txyon/MoNE_Portfolio/ImagePlots/lenscals.jpg

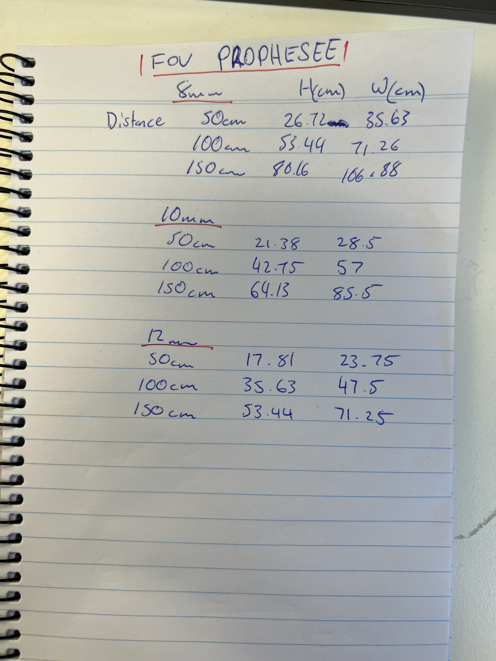
ImagePlots/lenscals.jpg
