txyon/MoNE_Portfolio/(commit log)

2024-01-13 Time filter for CSV files
2024-01-15 Original prototype code
    Built on psee413 by Alex. As seen in code added additional threads for bias controls to see if any constraints during manual testing.
2024-01-15 Hot Pixel Detection and Filtering
2024-01-15 Hot pixel detection and filter
