txyon/MoNE_Portfolio/ImagePlots/lux.jpg

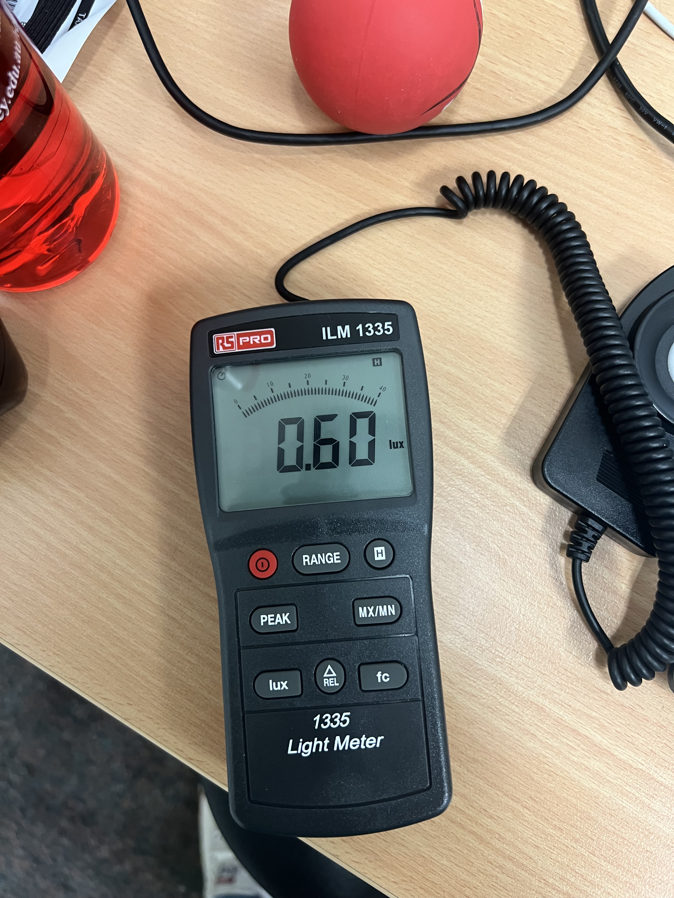
ImagePlots/lux.jpg
