txyon/MoNE_Portfolio/ExperimentSetup.jpg

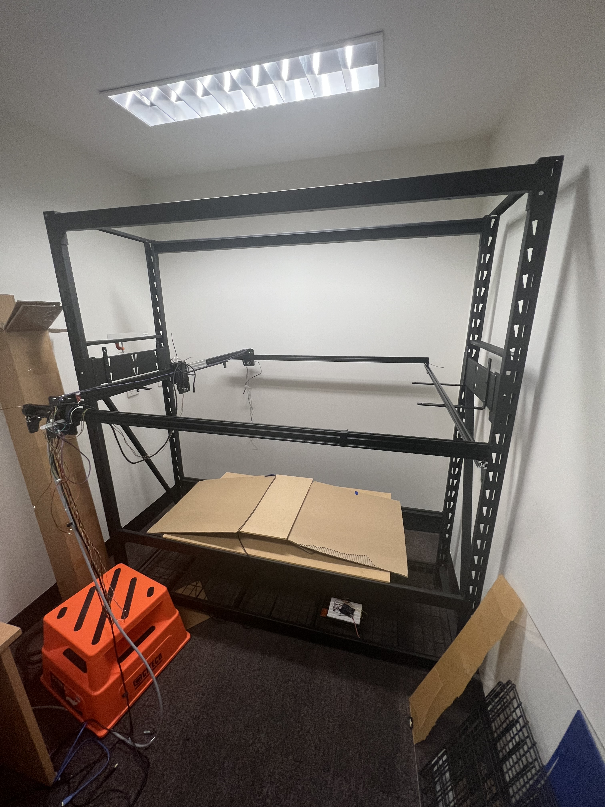
[picture p3: ImagePlots/ExperimentSetup.jpg]
ExperimentSetup.jpg
