txyon/MoNE_Portfolio/ImagePlots/Undersizeoptics.jpg

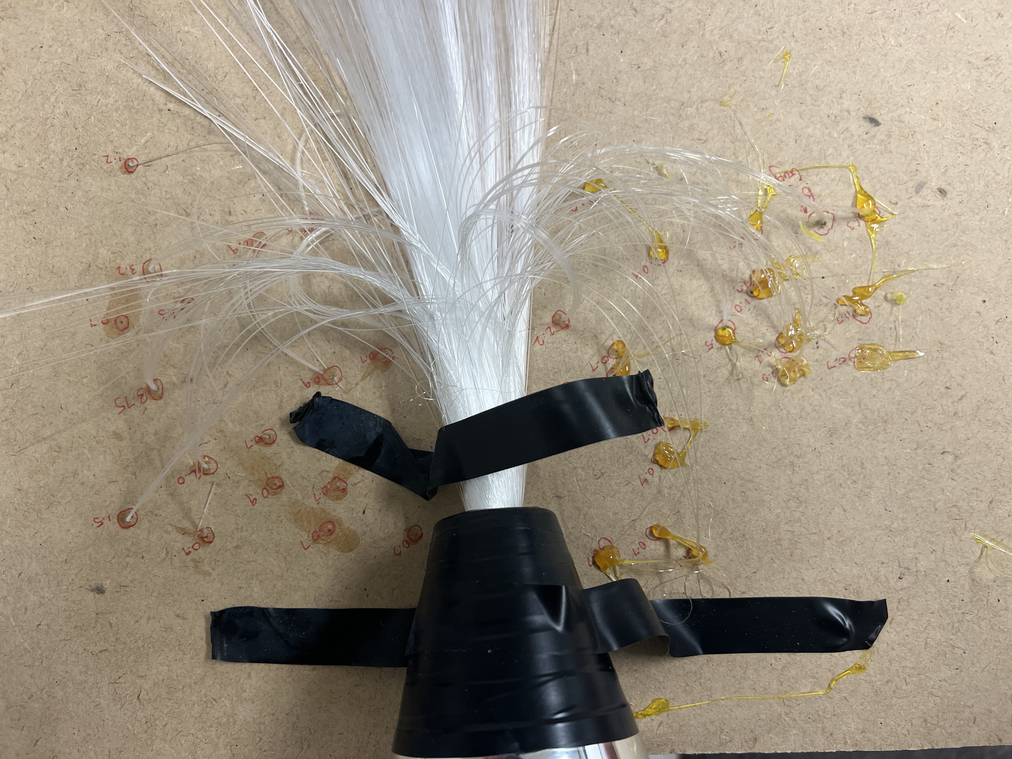
[picture p5: ImagePlots/Undersizeoptics.jpg]
ImagePlots/Undersizeoptics.jpg
